ahancock516/T27-GPS-Denied-Drone/3D_Print/ai_drone_rear_gps_mount.stl

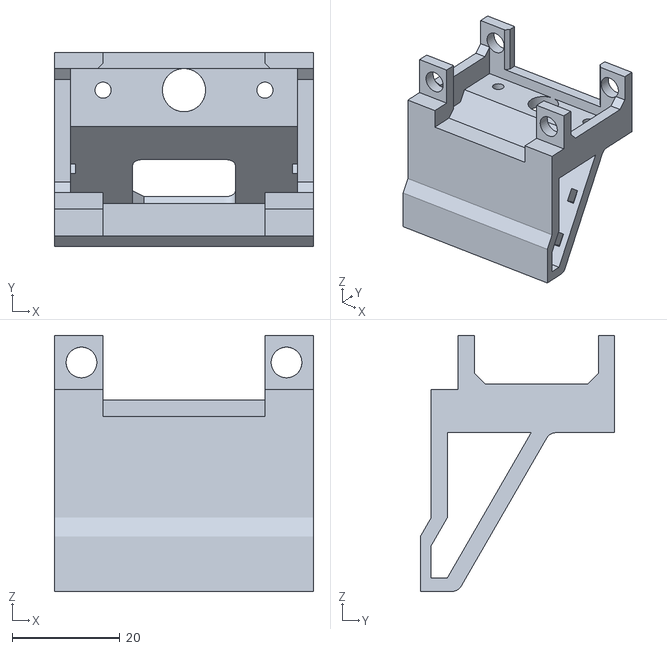
[picture p2: CAD file, 2026-01-10]
3D_Print/ai_drone_rear_gps_mount.stl
48.0 x 36.0 x 47.4
