ahancock516/T27-GPS-Denied-Drone/3D_Print/ai_drone_camera_hinge_front.stl

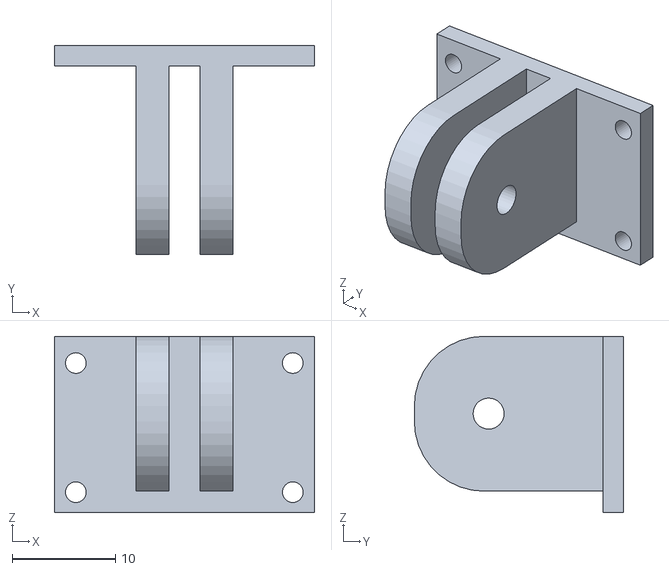
[picture p3: CAD file, 2025-12-14]
3D_Print/ai_drone_camera_hinge_front.stl
25.2 x 20.3 x 17.1
