ahancock516/T27-GPS-Denied-Drone/3D_Print/ai_drone_under_plate.stl

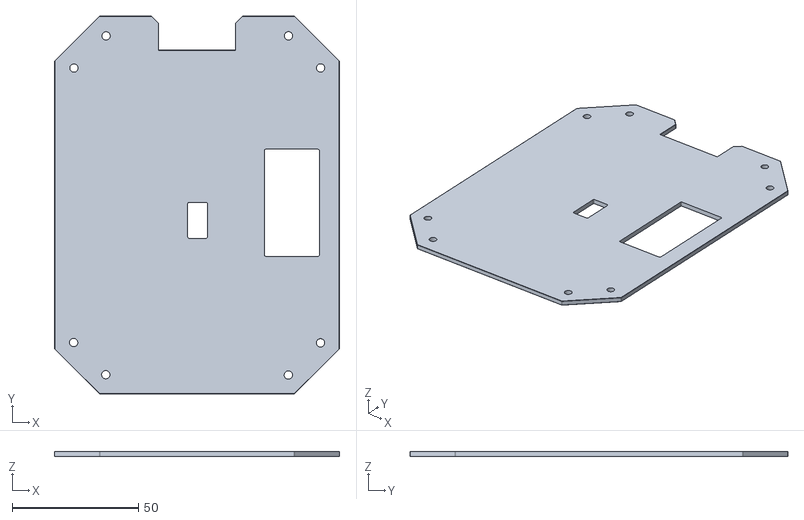
[picture p4: CAD file, 2025-12-14]
3D_Print/ai_drone_under_plate.stl
112.9 x 149.6 x 2.00
