ahancock516/T27-GPS-Denied-Drone/3D_Print/ai_drone_top_chassis.stl

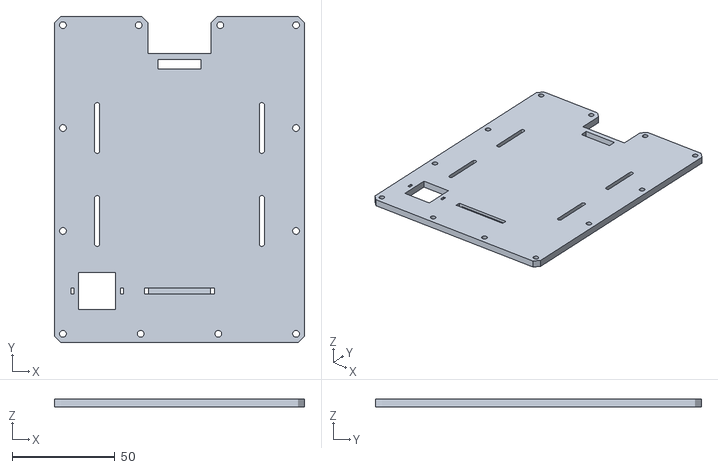
[picture p5: CAD file, 2025-12-14]
3D_Print/ai_drone_top_chassis.stl
121.7 x 158.4 x 4.00
