ahancock516/T27-GPS-Denied-Drone/3D_Print/ai_drone_bottom_chassis.stl

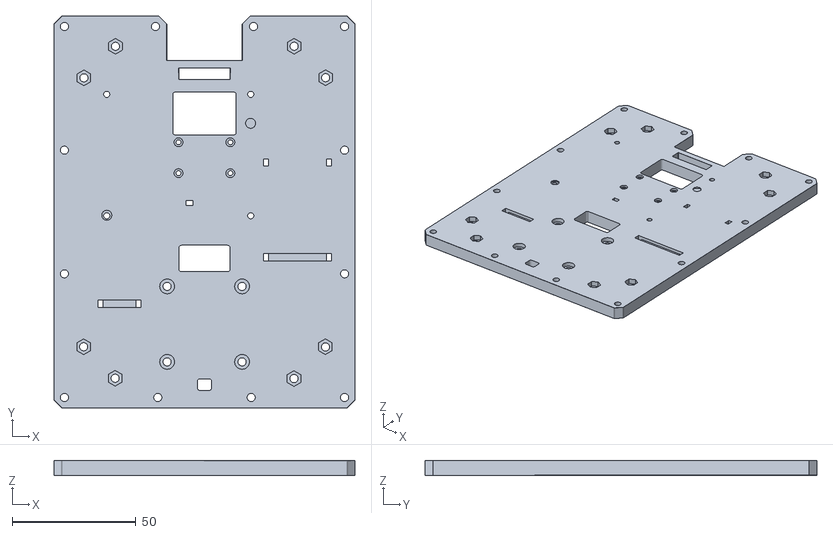
[picture p6: CAD file, 2025-12-14]
3D_Print/ai_drone_bottom_chassis.stl
121.7 x 158.4 x 6.01
