ahancock516/T27-GPS-Denied-Drone/3D_Print/ai_drone_arm.stl

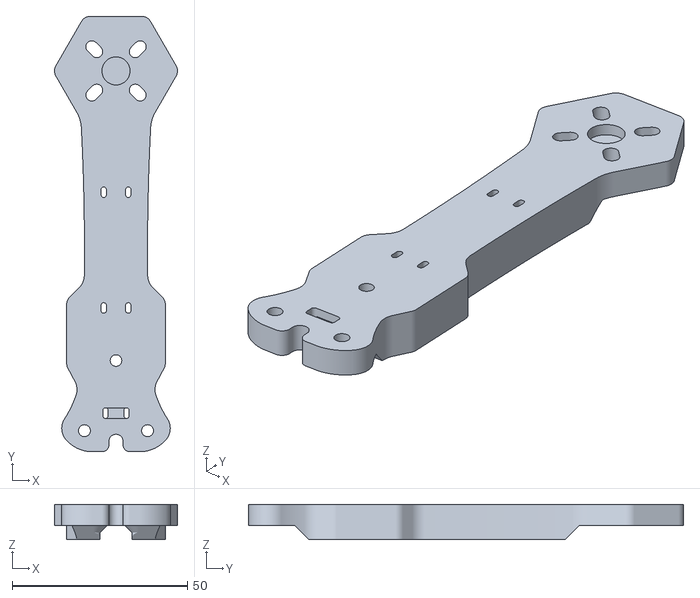
[picture p7: CAD file, 2025-12-14]
3D_Print/ai_drone_arm.stl
35.1 x 124.2 x 10.0
