ahancock516/T27-GPS-Denied-Drone/3D_Print/ai_drone_camera_hinge_back.stl

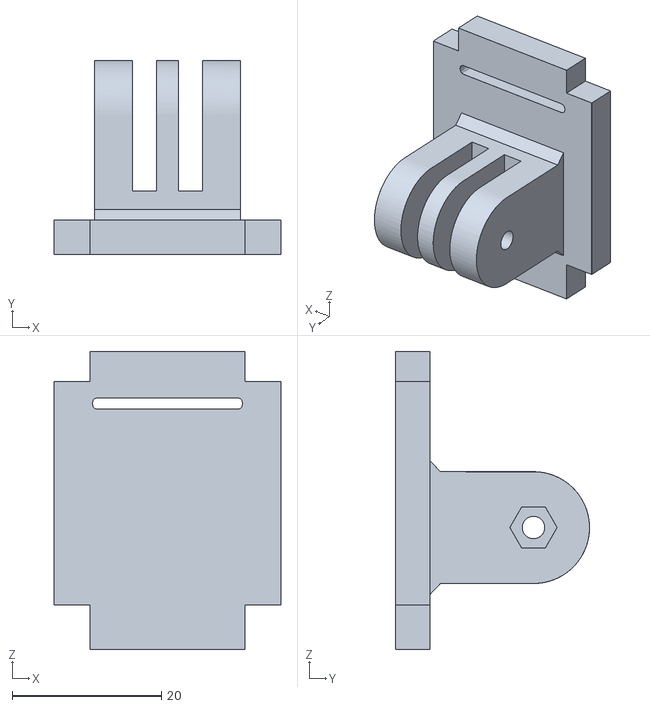
[picture p8: CAD file, 2025-12-14]
3D_Print/ai_drone_camera_hinge_back.stl
30.5 x 26.1 x 40.0
