ahancock516/T27-GPS-Denied-Drone/(list of files, cad)

Other CAD files:
3D_Print/GPS_Mast_55mm.gcode.3mf
3D_Print/Rear GPS Mount.gcode.3mf
