ahancock516/T27-GPS-Denied-Drone/3D_Print/README.txt

This UAV Design was devloped by Gabrial Garcia - garciag2022@fau.edu.

Print all frame parts with PLA at 30% Gyroid Infill, 3 walls.
PETG is not suitable as it is too flexible and will introduce vibrations into the system.

Print camera mount with TPU 50% infill. This reduces effect of vibrations on visual data collection.
