ahancock516/T27-GPS-Denied-Drone/Ardupilot/Vehicle_Params.params

1	1	ATC_ANGLE_BOOST	1	2
1	1	ATC_ANG_LIM_TC	1.000000000000000000	9
1	1	ATC_ANG_PIT_P	4.500000000000000000	9
1	1	ATC_ANG_RLL_P	4.500000000000000000	9
1	1	ATC_ANG_YAW_P	4.500000000000000000	9
1	1	ATC_RATE_FF_ENAB	1	2
1	1	ATC_RATE_P_MAX	0.000000000000000000	9
1	1	ATC_RATE_R_MAX	0.000000000000000000	9
1	1	ATC_RATE_Y_MAX	0.000000000000000000	9
1	1	ATC_RAT_PIT_D	0.003599999938160181	9
1	1	ATC_RAT_PIT_D_FF	0.000000000000000000	9
1	1	ATC_RAT_PIT_FF	0.000000000000000000	9
1	1	ATC_RAT_PIT_FLTD	20.000000000000000000	9
1	1	ATC_RAT_PIT_FLTE	0.000000000000000000	9
1	1	ATC_RAT_PIT_FLTT	20.000000000000000000	9
1	1	ATC_RAT_PIT_I	0.140000000596046448	9
1	1	ATC_RAT_PIT_IMAX	0.500000000000000000	9
1	1	ATC_RAT_PIT_NEF	0	2
1	1	ATC_RAT_PIT_NTF	0	2
1	1	ATC_RAT_PIT_P	0.140000000596046448	9
1	1	ATC_RAT_PIT_PDMX	0.000000000000000000	9
1	1	ATC_RAT_PIT_SMAX	0.000000000000000000	9
1	1	ATC_RAT_RLL_D	0.003599999938160181	9
1	1	ATC_RAT_RLL_D_FF	0.000000000000000000	9
1	1	ATC_RAT_RLL_FF	0.000000000000000000	9
1	1	ATC_RAT_RLL_FLTD	20.000000000000000000	9
1	1	ATC_RAT_RLL_FLTE	0.000000000000000000	9
1	1	ATC_RAT_RLL_FLTT	20.000000000000000000	9
1	1	ATC_RAT_RLL_I	0.140000000596046448	9
1	1	ATC_RAT_RLL_IMAX	0.500000000000000000	9
1	1	ATC_RAT_RLL_NEF	0	2
1	1	ATC_RAT_RLL_NTF	0	2
1	1	ATC_RAT_RLL_P	0.140000000596046448	9
1	1	ATC_RAT_RLL_PDMX	0.000000000000000000	9
1	1	ATC_RAT_RLL_SMAX	0.000000000000000000	9
1	1	ATC_RAT_YAW_D	0.000000000000000000	9
1	1	ATC_RAT_YAW_D_FF	0.000000000000000000	9
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
1	1	SERVO7_REVERSED	0	2
1	1	SERVO7_TRIM	1500	4
1	1	SERVO8_FUNCTION	58	4
1	1	SERVO8_MAX	1900	4
1	1	SERVO8_MIN	1100	4
1	1	SERVO8_REVERSED	0	2
1	1	SERVO8_TRIM	1500	4
1	1	SERVO9_FUNCTION	0	4
1	1	SERVO9_MAX	1900	4
1	1	SERVO9_MIN	1100	4
1	1	SERVO9_REVERSED	0	2
1	1	SERVO9_TRIM	1500	4
