ahancock516/T27-GPS-Denied-Drone/(commit log)

2025-11-26 Fixed Mavros stream rate issue by overriding timesync_rate & system_time_rate to 0.0 in the apm_config.yaml file
    [apm_config.yaml]
2025-12-14 Update print statement from 'Hello' to 'Goodbye'
2025-12-14 Add UAV STL Files.
    Custom UAV Platform developed by Gabriel Garcia.
    [ai_drone_arm.stl, ai_drone_bottom_chassis.stl, ai_drone_camera_hinge_back.stl, ai_drone_camera_hinge_front.stl, ai_drone_top_chassis.stl, ai_drone_under_plate.stl]
2025-12-14 Add README with UAV design and printing instructions
    Added printing guidelines and design credits for UAV.
2025-12-14 Deleted misplaced STL Files and Updated README - added STL File Table & Print Settings
    [ai_drone_arm.stl, ai_drone_bottom_chassis.stl, ai_drone_camera_hinge_back.stl, ai_drone_camera_hinge_front.stl, ai_drone_top_chassis.stl, ai_drone_under_plate.stl]
2025-12-22 Added Ardupilot Params file and update README.
    [Vehicle_Params.params]
2025-12-22 Updated README - Added Active Buzzer Wiring Diagram and Systemctl Startup Service.
2026-01-08 Updated Ardupilot Params & README
    [Vehicle_Params.params]
2026-01-10 Added rear_gps_mount stl
    [ai_drone_rear_gps_mount.stl]
